fregacmols/RotaryCell/hardware/ag1171-carrier-through-hole/README.md

# AG1171 Carrier Through-Hole — as ordered

Submitted to JLCPCB on August 28, 2026. These files are an immutable record of
the order. Boards from this package have been hand assembled and tested in
multiple working RotaryCell conversions, including calling, ringing, audio and
GPIO21-controlled idle power saving.

| File type | Included |
| --- | --- |
| EasyEDA schematic source | Yes |
| EasyEDA PCB source | Yes |
| Gerber and drill package | Yes |
| Assembly BOM / pick-and-place | No — intended for hand assembly |

Confirm the AG1171 orientation and every connector pin against the schematic before assembly. Do not edit the as-ordered files in place; place subsequent revisions in a new directory.

## Downloads

Filenames were standardized on September 16, 2026. File contents are byte-for-byte identical to the original order exports. Internal EasyEDA project names may retain the historical name.

- Gerbers — upload for PCB fabrication: [ESP-RotaryCell_AG1171-Carrier_Through-Hole_2026-08-28_Gerbers.zip](ESP-RotaryCell_AG1171-Carrier_Through-Hole_2026-08-28_Gerbers.zip)
- PCB source: [ESP-RotaryCell_AG1171-Carrier_Through-Hole_2026-08-28_PCB.json](ESP-RotaryCell_AG1171-Carrier_Through-Hole_2026-08-28_PCB.json)
- Schematic source: [ESP-RotaryCell_AG1171-Carrier_Through-Hole_2026-08-28_Schematic.json](ESP-RotaryCell_AG1171-Carrier_Through-Hole_2026-08-28_Schematic.json)
