fregacmols/RotaryCell/hardware/audio-reset-a4/README.md

# Audio and Reset A4 — as ordered

Submitted to JLCPCB on August 27, 2026. These files are an immutable record of
the order. Boards from this package have been assembled and tested in multiple
working RotaryCell conversions, including bidirectional audio and the GPIO35
hardware power-cycle path.

| File type | Included |
| --- | --- |
| EasyEDA schematic source | Yes |
| EasyEDA PCB source | Yes |
| Gerber and drill package | Yes |
| JLCPCB BOM | Yes |
| JLCPCB pick-and-place | Yes |

The design combines the passive, adjustable audio interface with a hardware
power-cycle circuit that operates the LilyGO physical switch path. The required
guide firmware v0.11.1-dev drives its reset trigger from GPIO35.

Do not edit the as-ordered files in place. Place subsequent revisions in a new directory.

## Downloads

Filenames were standardized on September 16, 2026. File contents are byte-for-byte identical to the original order exports. Internal EasyEDA project names may retain the historical name.

- BOM — upload for assembly: [ESP-RotaryCell_Audio-Reset_RevA4_BOM.csv](ESP-RotaryCell_Audio-Reset_RevA4_BOM.csv)
- Gerbers — upload for PCB fabrication: [ESP-RotaryCell_Audio-Reset_RevA4_Gerbers.zip](ESP-RotaryCell_Audio-Reset_RevA4_Gerbers.zip)
- PCB source: [ESP-RotaryCell_Audio-Reset_RevA4_PCB.json](ESP-RotaryCell_Audio-Reset_RevA4_PCB.json)
- Pick-and-place — upload for assembly: [ESP-RotaryCell_Audio-Reset_RevA4_PickAndPlace.csv](ESP-RotaryCell_Audio-Reset_RevA4_PickAndPlace.csv)
- Schematic source: [ESP-RotaryCell_Audio-Reset_RevA4_Schematic.json](ESP-RotaryCell_Audio-Reset_RevA4_Schematic.json)
