fregacmols/RotaryCell/docs/firmware.md

# Firmware

This section will cover installing and updating RotaryCell firmware as part of a new build.

For the current source and binaries, see the repository's `firmware/current` and `firmware/prebuilt` directories. Detailed build-from-source instructions remain in `FIRMWARE_BUILDING.md` at the repository root.

## Planned documentation

- Selecting the correct firmware release
- Initial USB installation
- Configuration values that must be reviewed for a new build
- SIM and cellular setup
- Maintenance Wi-Fi
- OTA application updates
- Serial diagnostics
- Recovery procedures
