fregacmols/RotaryCell/hardware/legacy/v0.8/Mechanical_README.md

# Mechanical

No release mechanical files exist yet.

Place any validated board-holder or mounting STL used by this release in this folder, along with its editable source file when available. One or two simply named files are sufficient; no additional folder hierarchy is needed unless the project actually grows to require it.
