fregacmols/RotaryCell/hardware/legacy/v0.8/Transformer_Audio_Interface.pdf

## LilyGO SIM7670G - Ag1171 Transformer Audio Interface

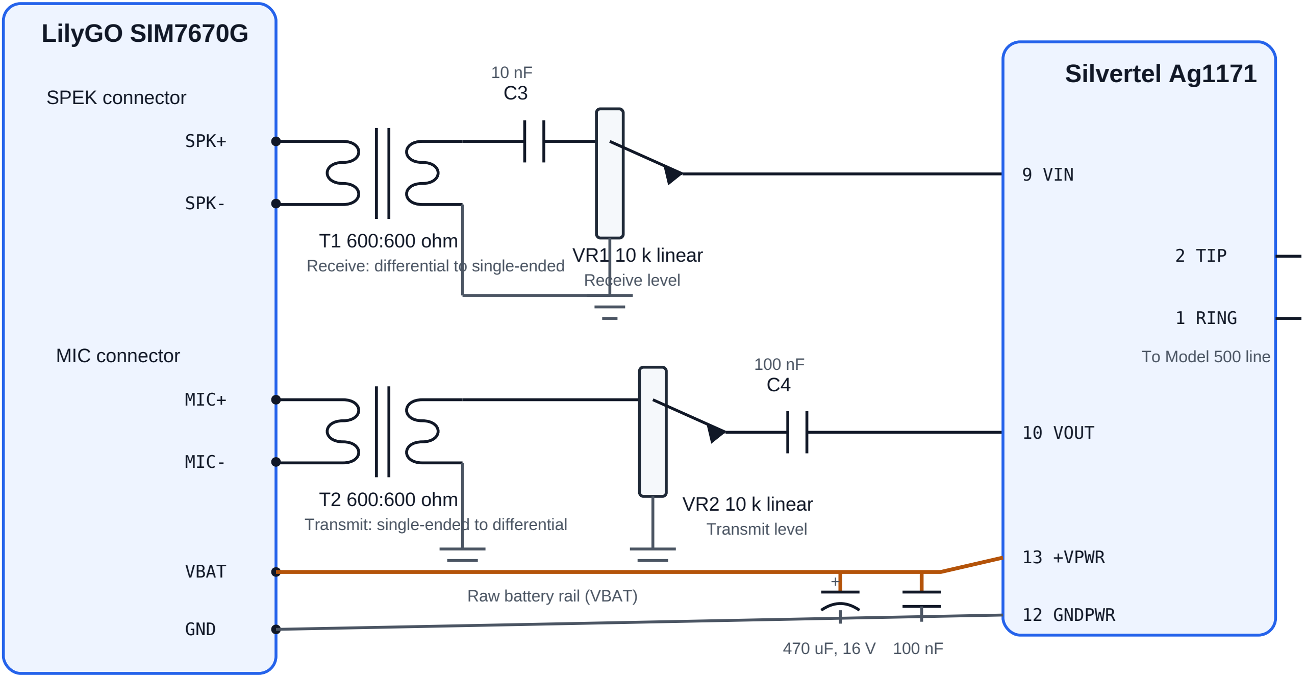
[picture p3: figure]
LilyGO SIM7670G; SPEK connector; SPK+; SPK-; MIC connector; MIC+; MIC-; VBAT; GND; T1 600:600 ohm Receive: differential to single-ended; VR1 10 k linear Receive level; T2 600:600 ohm Transmit: single-ended to differential; VR2 10 k linear Transmit level; Silvertel Ag1171; 9 VIN; 10 VOUT; 13 +VPWR; 12 GNDPWR; 2 TIP; 1 RING; To Model 500 line; Raw battery rail (VBAT)

Initial adjustment: turn both trimmer wipers fully toward ground, then raise levels gradually during a test call.
Do not ground either LilyGO audio conductor; grounding occurs only on the isolated Ag1171 side of each transformer.
