fregacmols/RotaryCell/docs/images/rotarycell-prototype.jpg

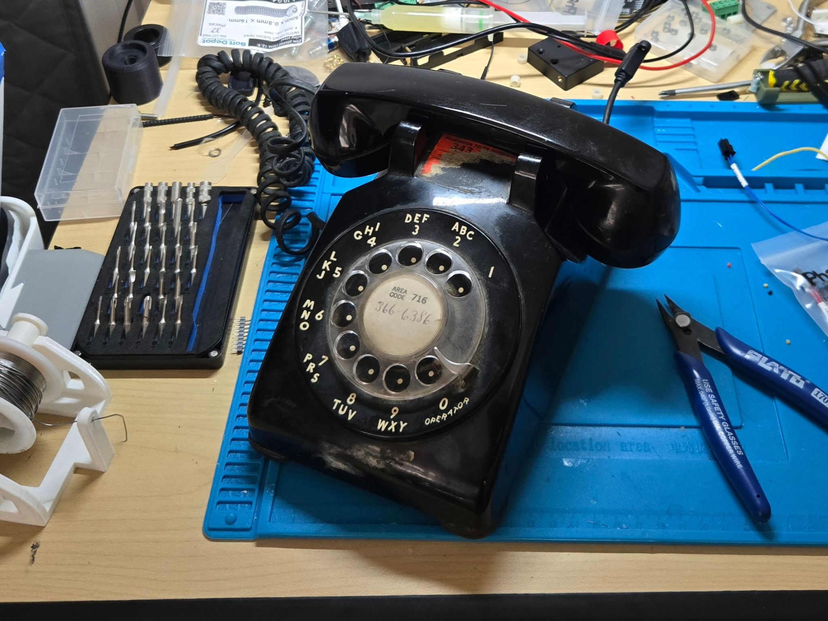
docs/images/rotarycell-prototype.jpg
