fregacmols/RotaryCell/hardware/audio-reset-a4/ESP-RotaryCell_Audio-Reset_RevA4_BOM.csv

ID | Name | Designator | Footprint | Quantity | Manufacturer Part | Manufacturer | Supplier | Supplier Part | Price
1 | 1uF | C1 | C0603 | 1 | CL10A105KB8NNNC | SAMSUNG(三星) | LCSC | C15849 | 0.006
2 | 10nF | C2 | C0603 | 1 | 0603B103K500NT | FH(风华) | LCSC | C57112 | 0.011
3 | 22nF | C3 | C0603 | 1 | CL10B223KB8NNNC | SAMSUNG(三星) | LCSC | C21122 | 0.01
4 | 220nF | C4 | C0603 | 1 | CL10B224KA8NNNC | SAMSUNG(三星) | LCSC | C21120 | 0.017
5 | 100nF | C5,C7 | C0603 | 2 | CC0603KRX7R9BB104 | YAGEO(国巨) | LCSC | C14663 | 0.015
6 | 4.7uF | C6 | C0805 | 1 | CC0805KKX7R6BB475 | YAGEO(国巨) | LCSC | C520074 | 0.083
7 | LILYGO | J1 | CONN-TH_B4B-XH-A-LF-SN | 1 | B4B-XH-A(LF)(SN) | JST | LCSC | C144395 | 0.081
8 | AG1171_AUDIO | J2 | CONN-TH_3P-P2.50_B3B-XH-A-LF-SN | 1 | B3B-XH-A(LF)(SN) | JST | LCSC | C144394 | 0.055
9 | DMP1012USS-13 | Q1 | SOIC-8_L4.9-W3.9-P1.27-LS6.0-BL | 1 | DMP1012USS-13 | DIODES(美台) | LCSC | C3001678 | 0.454
10 | 10K | R1,R4 | R0603 | 2 | 0603WAF1002T5E | UNI-ROYAL(厚声) | LCSC | C25804 | 0.005
11 | 3.3K | R2 | R0603 | 1 | 0603WAF3301T5E | UNI-ROYAL(厚声) | LCSC | C22978 | 0.003
12 | 1K | R3 | R0603 | 1 | 0603WAF1001T5E | UNI-ROYAL(厚声) | LCSC | C21190 | 0.003
13 | 820kΩ | R5 | R0603 | 1 | FRC0603F8203TS | FOJAN(富捷) | LCSC | C2907070 | 0.003
14 | 10kΩ | R6 | R0603 | 1 | 0603WAF1002T5E | UNI-ROYAL(厚声) | LCSC | C25804 | 0.005
15 | 100kΩ | R7,R9 | R0603 | 2 | 0603WAF1003T5E | UNI-ROYAL(厚声) | LCSC | C25803 | 0.004
16 | 1kΩ | R8 | R0603 | 1 | 0603WAF1001T5E | UNI-ROYAL(厚声) | LCSC | C21190 | 0.003
17 | SN74LVC1G123DCTT | U1 | SM8_L3.0-W2.8-P0.65-LS4.0-BL | 1 | SN74LVC1G123DCTT | TI(德州仪器) | LCSC | C354447 | 0.826
18 | B3B-XH-A(LF)(SN) | U2 | CONN-TH_3P-P2.50_A2501WV2-3P | 1 | B3B-XH-A(LF)(SN) | JST | LCSC | C144394 | 0.055
19 | 10K | SPK_LVL,MIC_LVL | RES-ADJ-TH_3362P | 2 | 3362P-1-103LF | BOURNS | LCSC | C58159 | 0.397
