fregacmols/RotaryCell/docs/legacy/v0.8/BOM.md

# Bill of Materials — v0.8 Prototype

Quantities and mounting hardware may vary with the physical build.

| Qty | Item | Notes |
|---:|---|---|
| 1 | Western Electric/AT&T Model 500 telephone | Original handset, dial, hookswitch, network, and bells retained |
| 1 | LilyGO T-A7670G-S3 Standard | A7670G-LLSE cellular modem board |
| 1 | Silvertel AG1171 | Ringing SLIC / telephone-line interface |
| 2 | 600:600-ohm audio transformer | EI-14-style telephone/audio transformer used in prototype |
| 2 | 10-kohm linear trimmer/potentiometer | VR1 receive, VR2 transmit |
| 1 | 10 nF capacitor | Receive coupling into AG1171 VIN |
| 1 | 100 nF capacitor | Transmit coupling from AG1171 VOUT |
| 1 | 100 nF capacitor | AG1171 supply bypass |
| 1 | 470 uF, 16 V capacitor | AG1171 supply bulk capacitor |
| 3 | 1-kohm resistor | Protective series resistors for control lines per Rev B schematic |
| 1 | Protected single-cell Li-ion battery | Appropriate size/capacity for installation |
| 1 | SpeedTalk or compatible SIM | Voice service compatible with A7670G and local network |
| as needed | Perfboard, wire, headers, connectors, heat-shrink, mounting hardware | Prototype construction |

Refer to the release schematics before purchasing or wiring components.
