fregacmols/RotaryCell/guide/docs/downloads/printed-parts/ag1171.stl

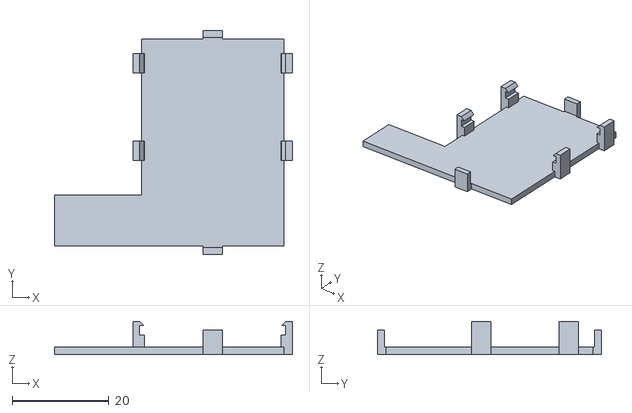
[picture p11: CAD file, 2026-09-25]
guide/docs/downloads/printed-parts/ag1171.stl
49.1 x 46.2 x 6.90
