fregacmols/RotaryCell/guide/docs/downloads/rear-connectors/Rect_USB_TestFit_R3.stl

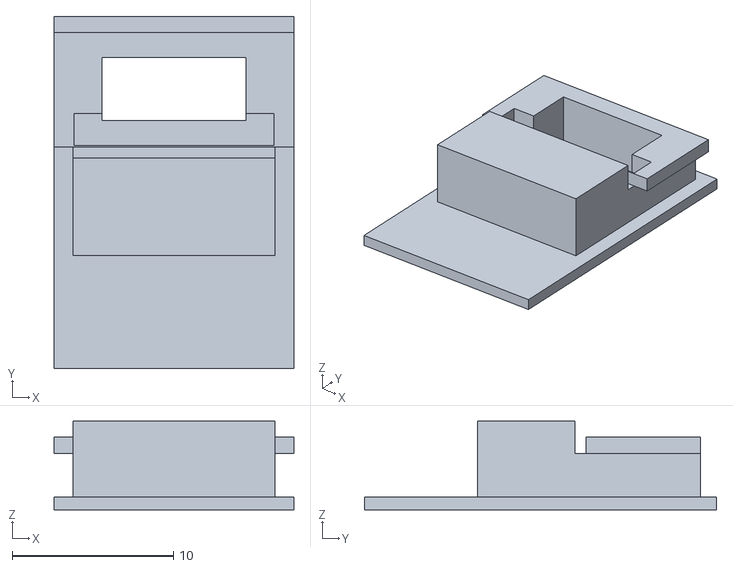
[picture p12: CAD file, 2026-09-25]
guide/docs/downloads/rear-connectors/Rect_USB_TestFit_R3.stl
14.9 x 21.8 x 5.50
