fregacmols/RotaryCell/guide/docs/downloads/printed-parts/audio.stl

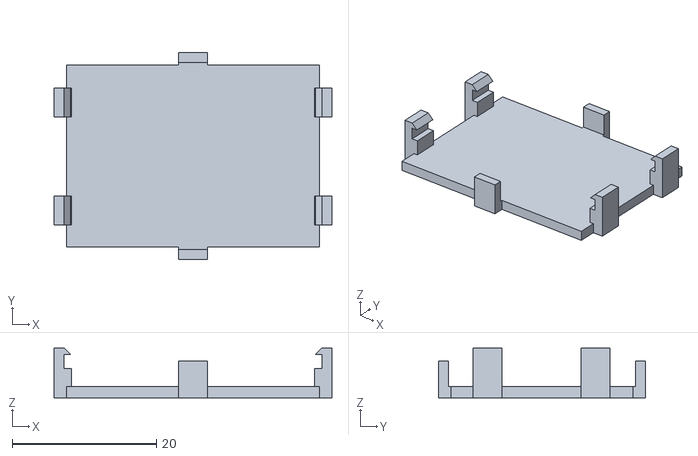
[picture p13: CAD file, 2026-09-25]
guide/docs/downloads/printed-parts/audio.stl
38.5 x 28.6 x 6.90
