fregacmols/RotaryCell/guide/docs/downloads/rear-connectors/Arch_USB_TestFit_R1.stl

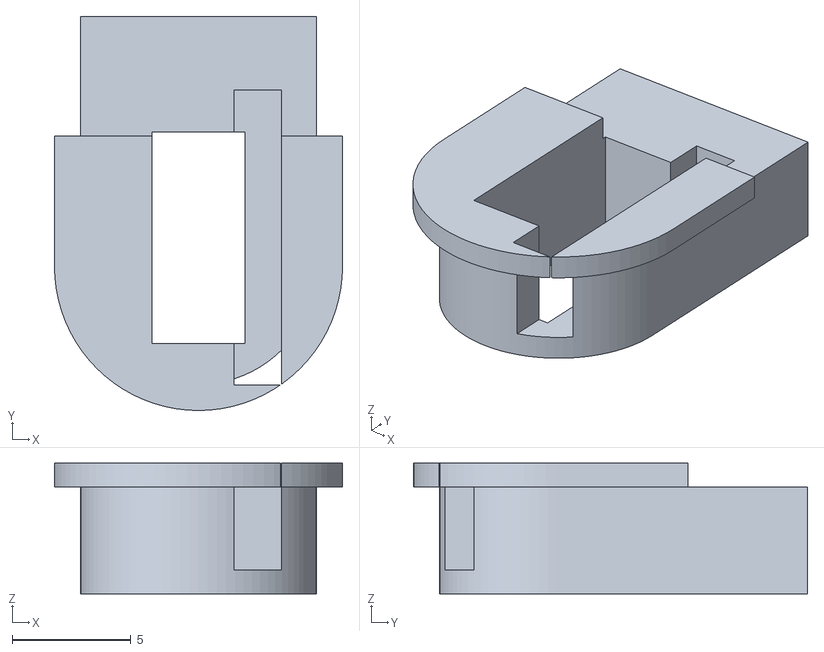
[picture p14: CAD file, 2026-09-25]
guide/docs/downloads/rear-connectors/Arch_USB_TestFit_R1.stl
12.1 x 16.6 x 5.50
