fregacmols/RotaryCell/guide/docs/downloads/printed-parts/LilyGO_Dial_Support_Carrier.stl

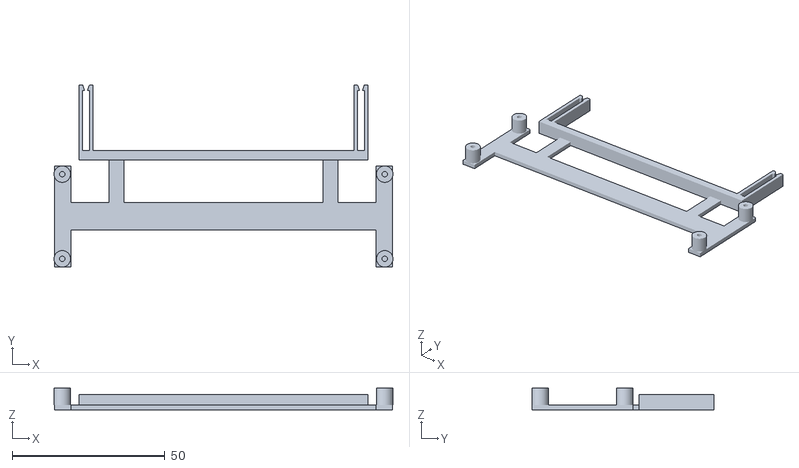
[picture p15: CAD file, 2026-09-25]
guide/docs/downloads/printed-parts/LilyGO_Dial_Support_Carrier.stl
111.0 x 59.6 x 7.10
