fregacmols/RotaryCell/guide/docs/mounting.md

<span class="kicker">RotaryCell / build guide</span>

# Install the assemblies

The telephone shown here is a Western Electric Model 500. Take a clear photograph of its original wiring before moving anything; wire colors and earlier repairs vary from phone to phone.

## 1. Open the telephone

Turn the phone over and loosen the two housing screws shown below. Lift off the shell without pulling on the wiring.

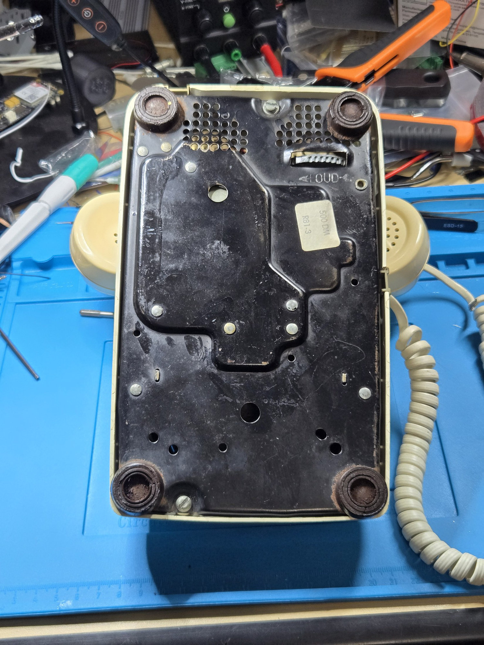
[picture p36: guide/docs/images/phone-housing-screws.jpg]
The two housing screws on the underside of the telephone


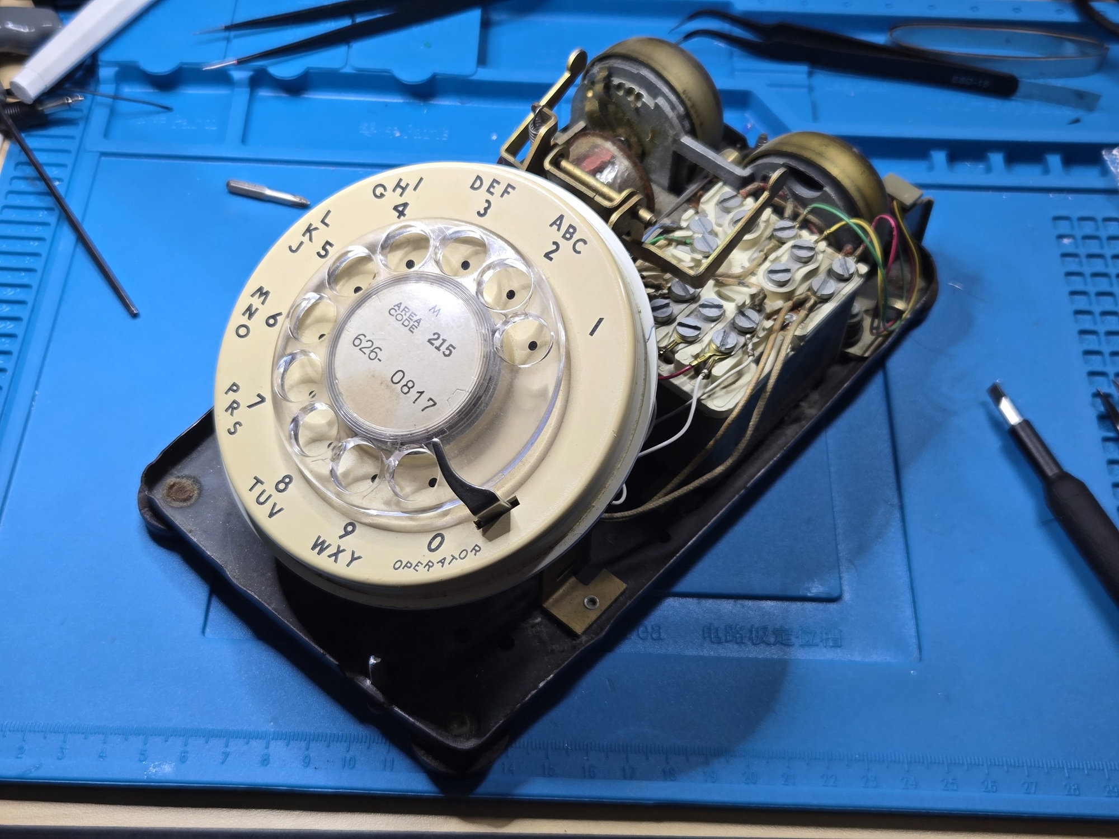
[picture p37: guide/docs/images/phone-housing-removed.jpg]
Telephone with the outer housing removed


Loosen the two flathead screws that retain the dial assembly, one on each mounting post. Back both screws out a good distance, but do not remove them completely. Lift the dial assembly free of the posts and move it aside far enough to expose the base. Leave its original wiring attached and avoid hanging its weight from the wires. Close-up photographs of these screws appear later when the dial is reinstalled.

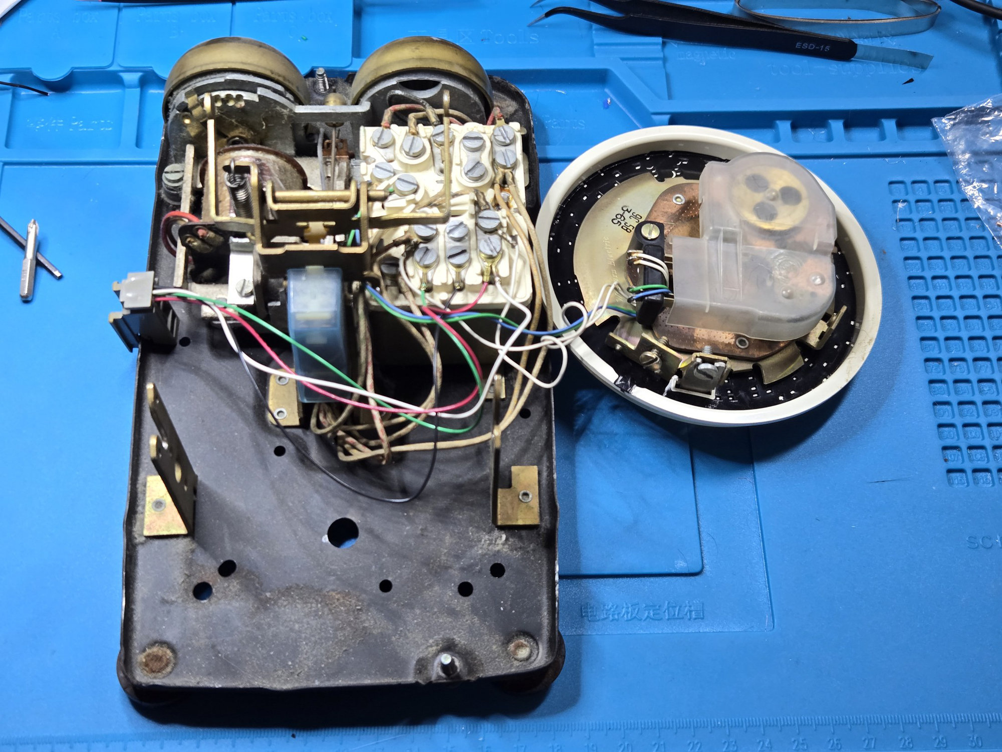
[picture p38: guide/docs/images/phone-dial-moved-aside.jpg]
Dial assembly moved aside while its wiring remains connected


## 2. Free the rear-connector wiring

The original modular jack in this phone used four spade lugs on the network block. Photograph their locations, then disconnect them so the network terminals and rear opening are available for the RotaryCell installation. The next page covers the available rear-connector options.

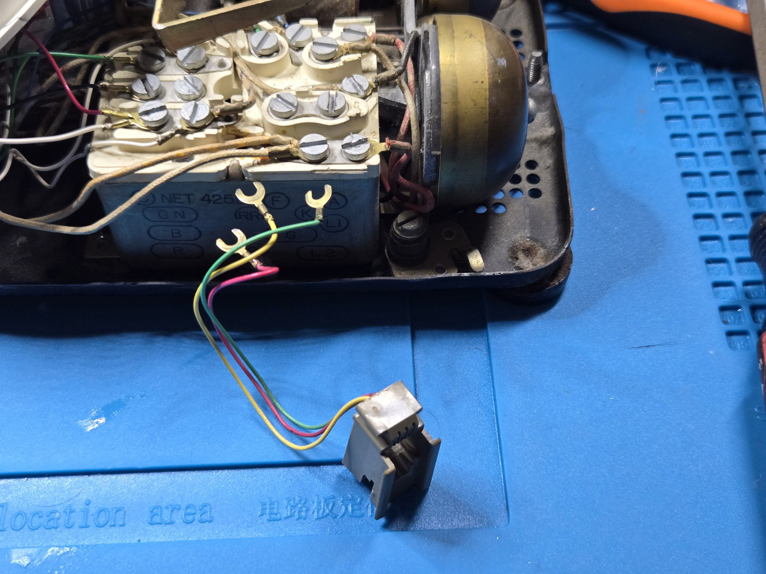
[picture p39: guide/docs/images/phone-original-jack-wiring.jpg]
Original modular jack wiring disconnected from the network block


## 3. Fit the board carriers

Apply 3M VHB tape to the underside of the two small printed carriers as shown. Press them onto the metal base in the positions shown in the following photograph.

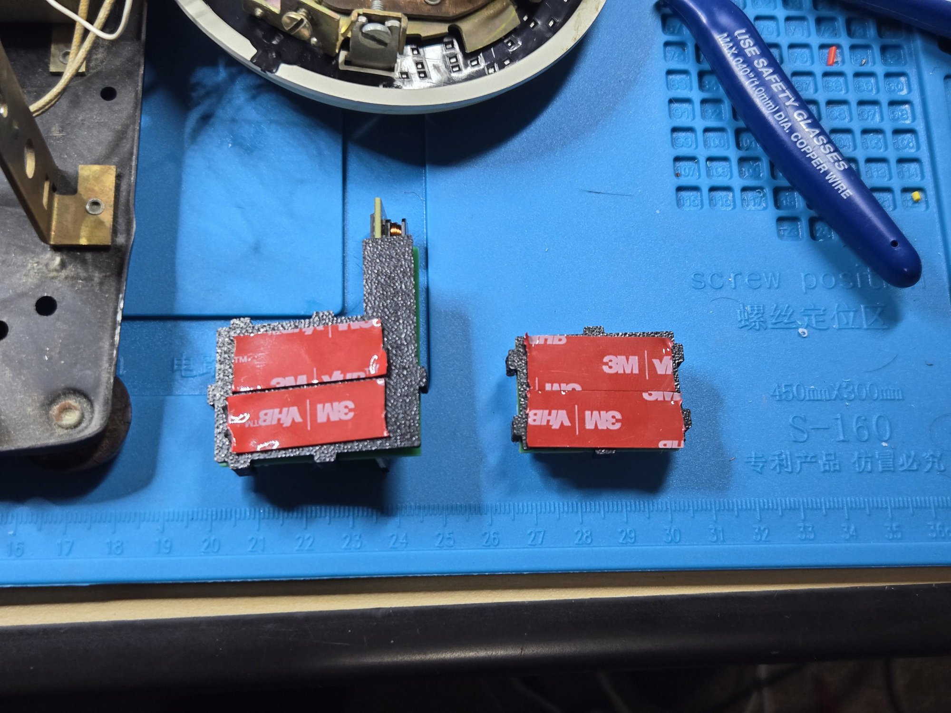
[picture p40: guide/docs/images/phone-carriers-adhesive.jpg]
VHB tape fitted to the underside of the two small board carriers


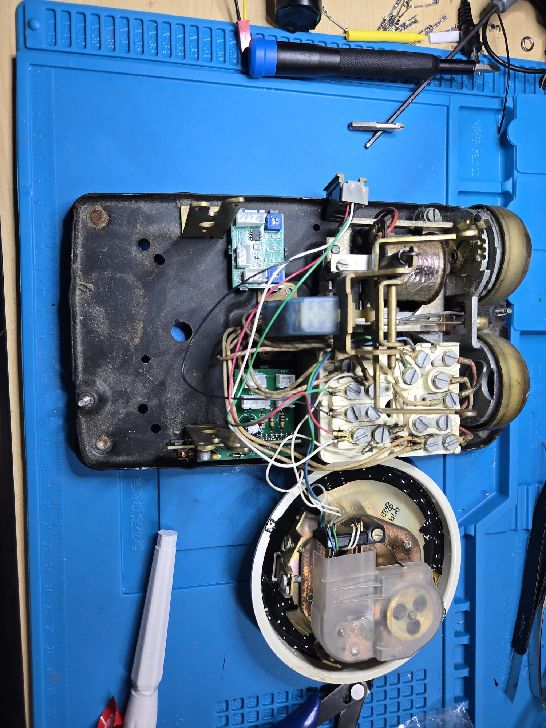
[picture p41: guide/docs/images/phone-carriers-installed.jpg]
Audio and AG1171 carrier assemblies installed on the telephone base


Fit the LilyGO and its printed carrier along the open left side of the base. Plug in the prepared harnesses while the connectors are still easy to reach.

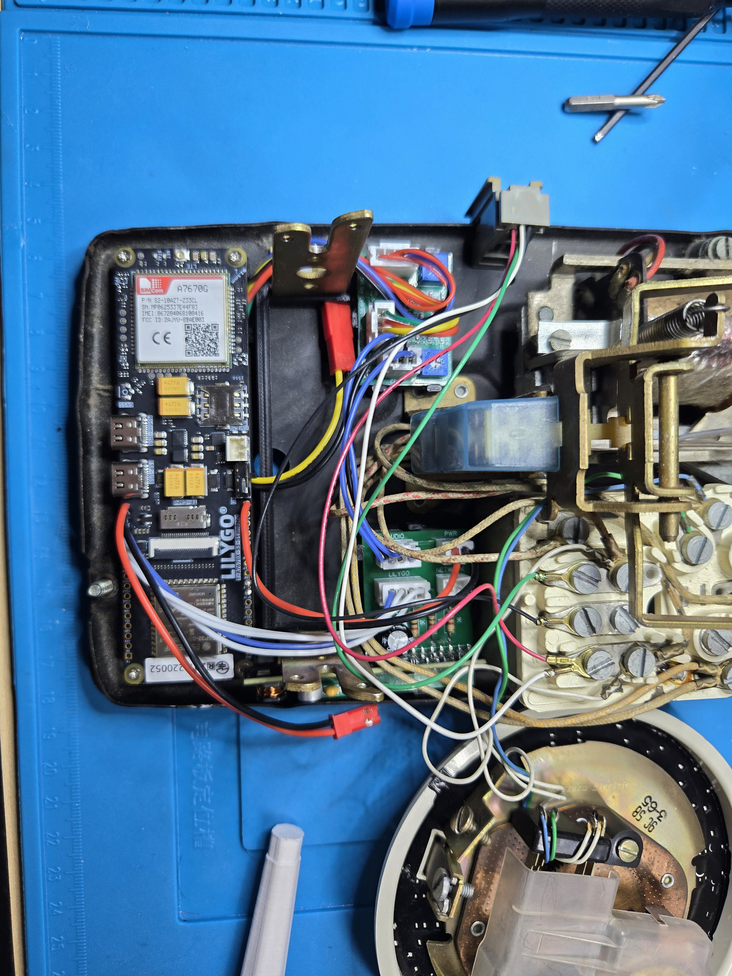
[picture p42: guide/docs/images/phone-boards-installed.jpg]
LilyGO and the two smaller boards installed and connected


## 4. Add the battery and telephone connection

Place the insulated 21700 between the LilyGO and the upper board. The lead lengths are intentionally different so the connectors reach their boards without leaving large coils of wire in the phone.

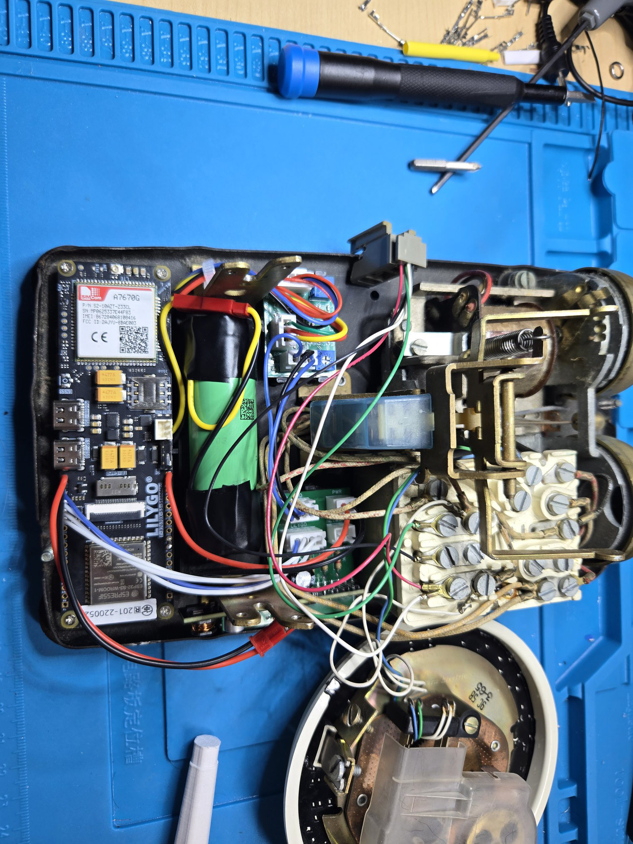
[picture p43: guide/docs/images/phone-battery-installed.jpg]
Battery installed between the LilyGO and the other assemblies


Connect the carrier's two-wire `NETWORK` harness to the telephone's original
incoming-line points on the network block. Green is tip and red is ring in this
build.

!!! warning "Network blocks vary"
    The photograph shows one particular telephone. Trace the original incoming
    line connection or consult the schematic for your telephone; do not copy
    these terminal positions or rely on its wire colors for a different model
    or revision. This internal pair must never be connected to the public
    telephone network or energized premises wiring.

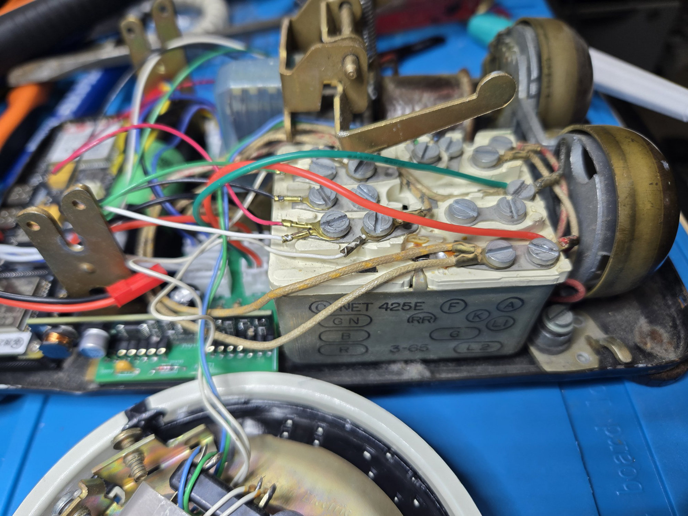
[picture p44: guide/docs/images/phone-network-tip-ring.jpg]
Green tip and red ring leads connected to the telephone network block


At this stage all three boards and the battery should sit below the dial mechanism, with the wiring lying inside the perimeter of the base. Leave the dial loose until firmware, calling and audio tests are complete.
