fregacmols/RotaryCell/guide/docs/index.md

<div class="hero">
  <div class="hero-copy">
    <span class="kicker">The RotaryCell build guide</span>
    <h1>Convert a rotary phone for cellular service.</h1>
    <p class="lead">Build the electronics, prepare the wiring, load the firmware and install RotaryCell in a Western Electric 500-series telephone.</p>
    <a href="materials.html" class="md-button md-button--primary">Start with materials →</a>
  </div>
  <div class="hero-visual">
    Completed red RotaryCell telephone centered on an electronics workbench
    <span>A completed RotaryCell conversion</span>
  </div>
</div>

<div class="intro-notes">
  <section>
    <span class="note-label">Before you begin</span>
    <h2>Experience expected</h2>
    <p>This is not an introductory electronics project. You should be comfortable soldering and desoldering, crimping small contacts, following pinouts and checking your work with a multimeter.</p>
  </section>
  <section>
    <span class="note-label">A note on the photos</span>
    <h2>Several phones, one guide</h2>
    <p>The photographs were taken across several builds. Shell colors, network blocks, original wiring and routing vary. Follow labels and written connections; use the photos for orientation and clearance. Wire colors only matter where the text assigns them a function.</p>
  </section>
</div>

## Build sequence

Follow the project in order from sourcing through the first call. Preparing the
LilyGO contains nearly all of the fine soldering and accounts for roughly
**80% of the hands-on assembly**. The work becomes much more straightforward
after that stage.

<div class="journey">
  <a class="journey-step" href="materials.html"><span class="step-number">01</span><span class="step-copy"><strong>Materials and sourcing</strong><small>Choose the parts, order the boards and prepare your tools.</small></span><span class="step-arrow">→</span></a>
  <a class="journey-step featured" href="lilygo.html"><span class="step-number">02</span><span class="step-copy"><strong>Prepare the LilyGO <em>Most of the hands-on work</em></strong><small>Remove the original holder and add the battery, audio, power and control connections.</small></span><span class="step-arrow">→</span></a>
  <a class="journey-step" href="assembly.html"><span class="step-number">03</span><span class="step-copy"><strong>Boards and wiring</strong><small>Populate the carrier, prepare the cables and assemble the battery leads.</small></span><span class="step-arrow">→</span></a>
  <a class="journey-step" href="firmware.html"><span class="step-number">04</span><span class="step-copy"><strong>Firmware and SIM</strong><small>Load the software and establish cellular service.</small></span><span class="step-arrow">→</span></a>
  <a class="journey-step" href="mounting.html"><span class="step-number">05</span><span class="step-copy"><strong>Install and adjust</strong><small>Mount everything, connect the phone and set the audio.</small></span><span class="step-arrow">→</span></a>
  <a class="journey-step" href="checks.html"><span class="step-number">06</span><span class="step-copy"><strong>Final checks</strong><small>Check calling, ringing and battery operation.</small></span><span class="step-arrow">→</span></a>
</div>

The guide follows the LilyGO controller, Audio/Reset A4 board and AG1171
carrier installed in a Western Electric Model 500 telephone.
