fregacmols/RotaryCell/docs/RotaryCell_Complete_Prototype_Wiring.pdf

# RotaryCell - Complete Prototype Wiring and Component Schematic

## Point-to-point hand-wiring guide for the working transformerless prototype

## PROTOTYPE HAND-WIRING REFERENCE

### Drawing RC-001 | Rev A | 2026-08-28

LEGEND: | battery power | audio | control | common ground | optional / not fitted | No PCB/connector abstraction: wires terminate at module pins and components

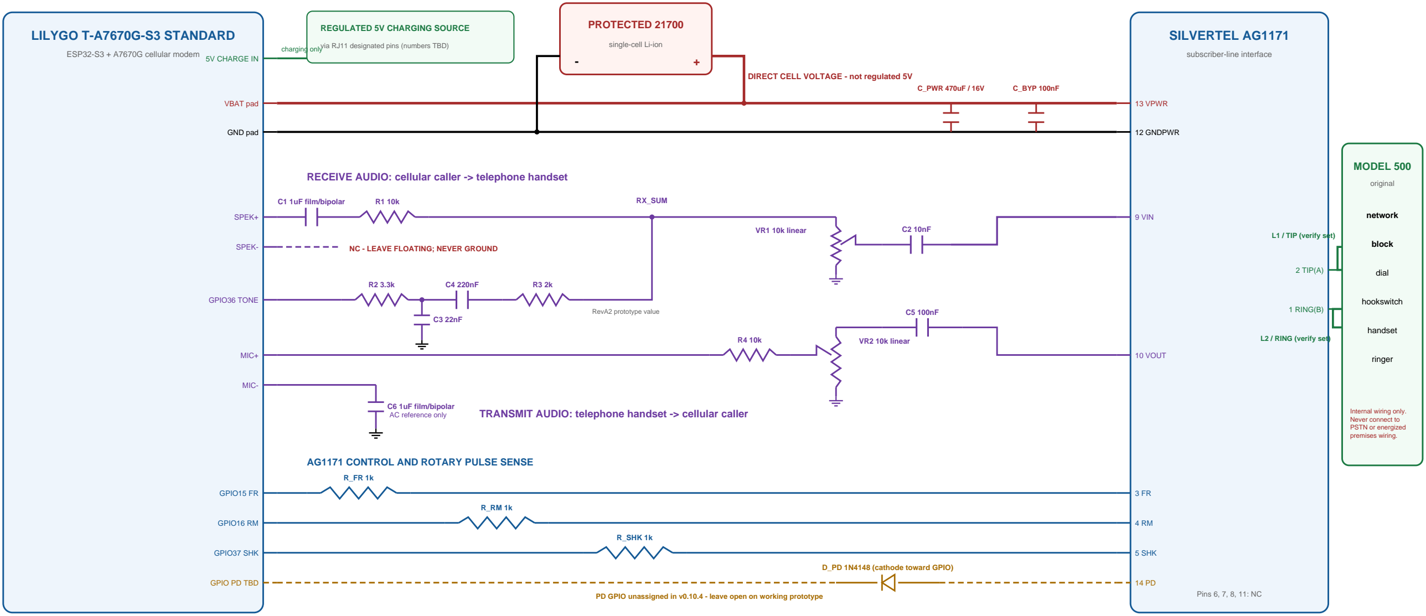
[picture p72: figure]
LILYGO T-A7670G-S3 STANDARD; ESP32-S3 + A7670G cellular modem; SILVERTEL AG1171; subscriber-line interface; MODEL 500; original; network; block; dial; hookswitch; handset; ringer; Internal wiring only. Never connect to PSTN or energized premises wiring.; 5V CHARGE IN; VBAT pad; GND pad; SPEK+; SPEK-; MIC+; MIC-; GPIO36 TONE; GPIO15 FR; GPIO16 RM; GPIO37 SHK; GPIO PD TBD; 13 VPWR; 12 GNDPWR; 9 VIN; 10 VOUT; 5 SHK; 2 TIP(A); 1 RING(B); Pins 6, 7, 8, 11: NC; REGULATED 5V CHARGING SOURCE; PROTECTED 21700; single-cell Li-ion - +; DIRECT CELL VOLTAGE - not regulated 5V; C_PWR 470uF / 16V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

via RJ11 designated pins (numbers TBD) charging only

## RECEIVE AUDIO: cellular caller -> telephone handset

## TRANSMIT AUDIO: telephone handset -> cellular caller

PD GPIO unassigned in v0.10.4 - leave open on working prototype

### BUILD / SAFETY NOTES

1. Audio values are the working RevA2 prototype values; R3 is 2k.
2. SPEK- stays floating. MIC- reaches ground only through the 1uF AC-reference capacitor.
3. The protected 21700 directly feeds LilyGO VBAT and AG1171 VPWR. Never put charging 5V on VPWR.
4. Set both 10k level trimmers for minimum signal before the first call, then raise slowly.
5. AG1171 pins 6, 7, 8, 11 are unconnected. Tip/Ring are internal to the telephone only.
6. RJ11 pin numbers and physical switch solder pads still require labeled photos.

## IMPORTANT: HAND-WIRING FITS, BUT PACKAGING IS CHALLENGING

The prototype can be built entirely from the modules and discrete components shown here and installed inside the original telephone without modifying it. Point-to-point parts and wiring occupy substantially more space than the PCB version, so expect repeated dry-fitting and careful routing.

- Lay out the LilyGO, protected 21700, AG1171, trimmers and audio components before cutting final wire lengths.
- Insulate every exposed joint and provide strain relief. Keep wiring clear of the dial, hookswitch and other moving metalwork.
- Check that the base closes without pinching wires or loading terminals. A complete hand-wired installation is absolutely possible, but it requires patience and deliberate placement.

RotaryCell RC-001 - working prototype hand-wiring reference
