fregacmols/RotaryCell/guide/overrides/main.html

{% extends "base.html" %} {% block announce %} RotaryCell build guide Questions and corrections are welcome. View the RotaryCell repository (https://github.com/fregacmols/RotaryCell) {% endblock %}
