fregacmols/RotaryCell/guide/docs/images/phone-final-wiring-before-closing.jpg

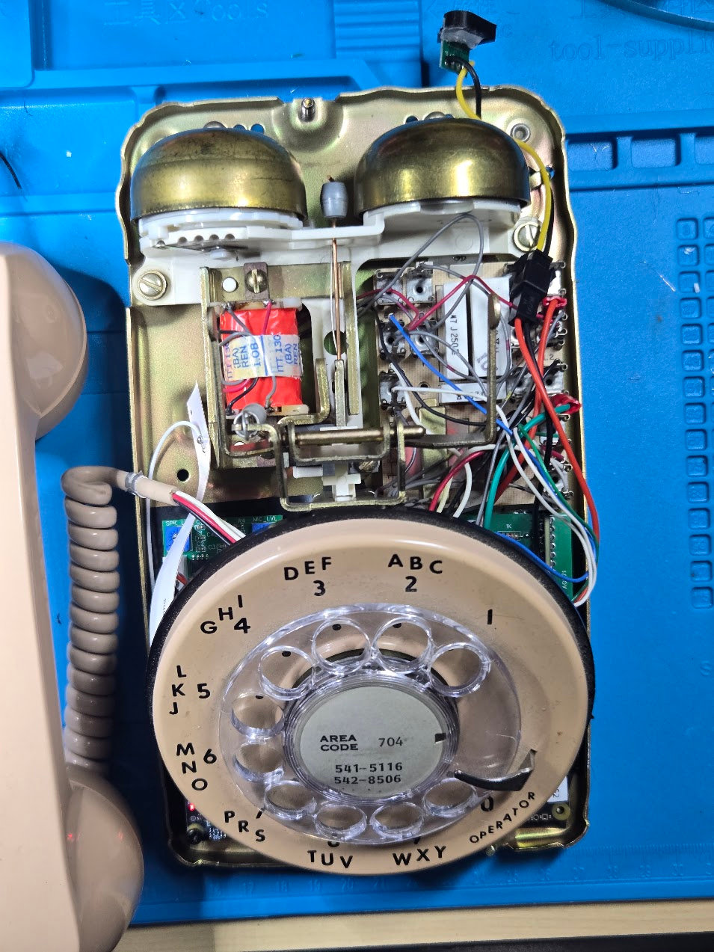
guide/docs/images/phone-final-wiring-before-closing.jpg
