fregacmols/RotaryCell/guide/docs/images/rotarycell-complete-phone.jpg

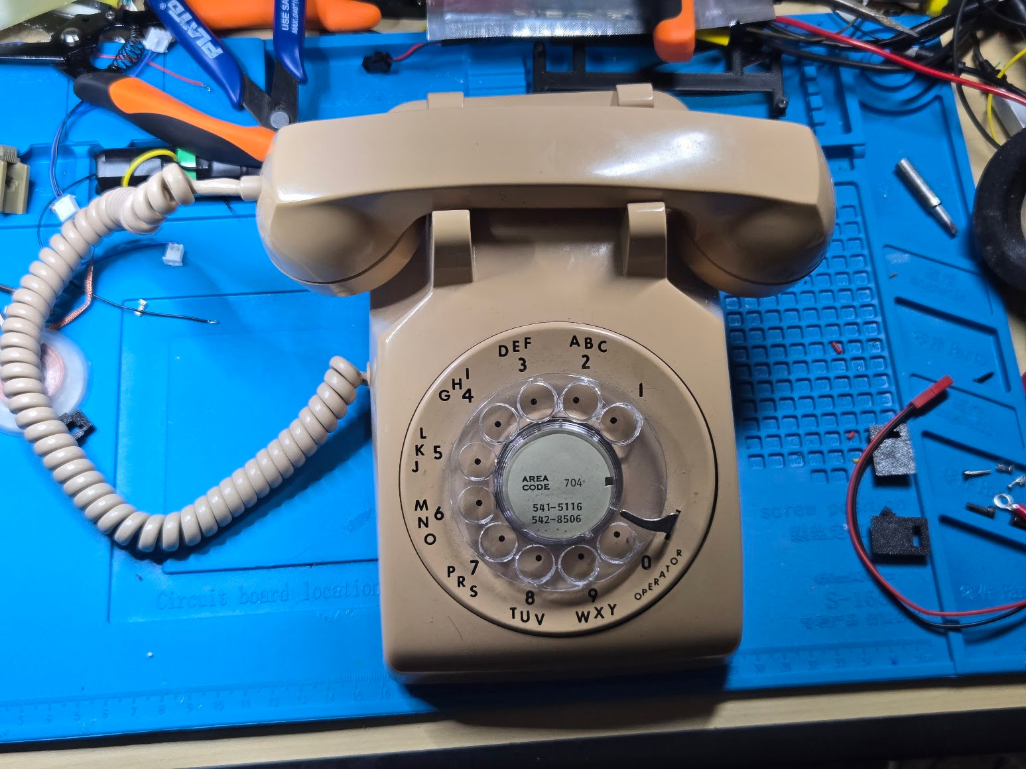
guide/docs/images/rotarycell-complete-phone.jpg
