fregacmols/RotaryCell/hardware/experimental/audio-interface/ESP-CellCore_Active_Audio_Interface_RevE2.pdf

# ESP-CellCore Active Audio Interface - Receive Path

## CELL -> ROTARY: LilyGO SPEK differential output to AG1171 VIN pin 9

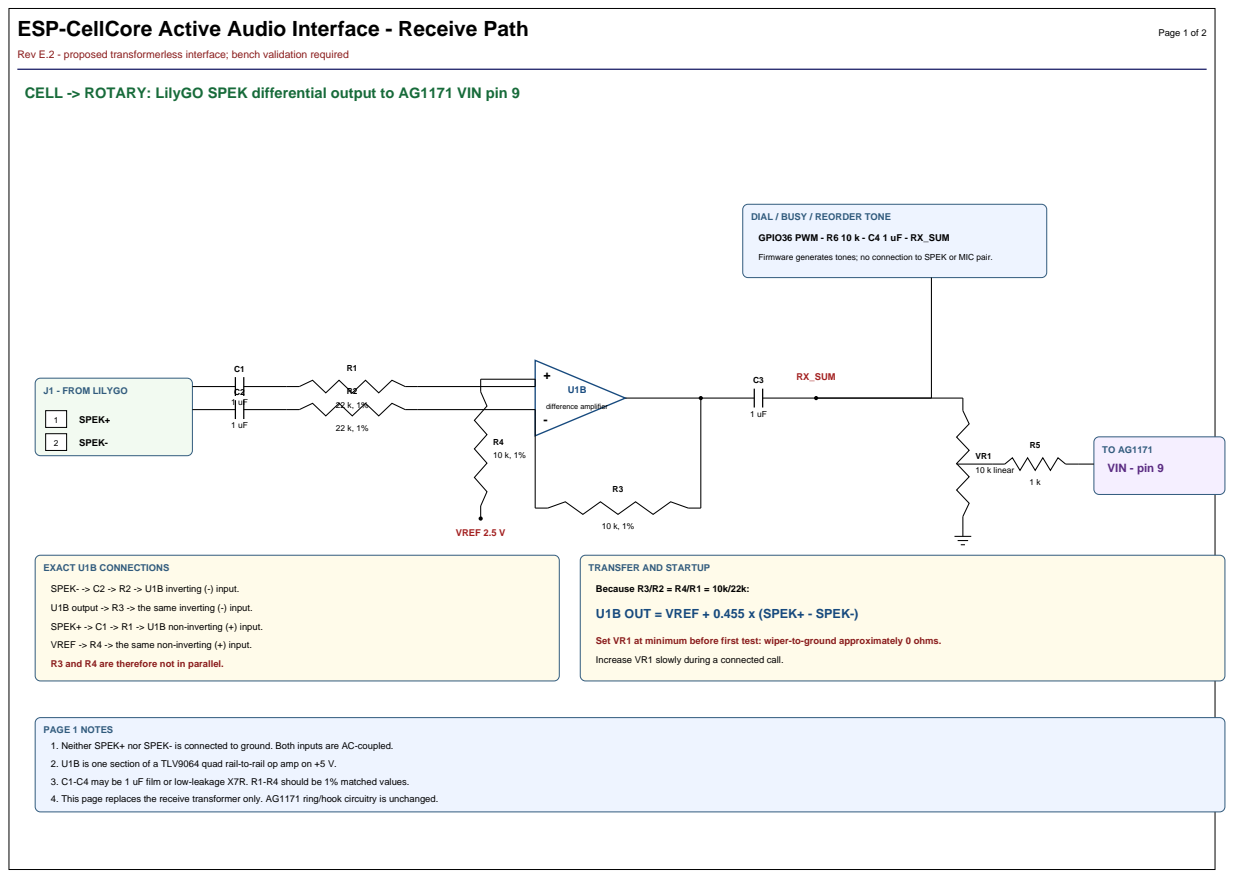
[picture p75: page 1]

Rev E.2 - proposed transformerless interface; bench validation required

DIAL / BUSY / REORDER TONE

Firmware generates tones; no connection to SPEK or MIC pair.

SPEK- -> C2 -> R2 -> U1B inverting (-) input.
U1B output -> R3 -> the same inverting (-) input.
SPEK+ -> C1 -> R1 -> U1B non-inverting (+) input.
VREF -> R4 -> the same non-inverting (+) input.
R3 and R4 are therefore not in parallel.

Because R3/R2 = R4/R1 = 10k/22k:
U1B OUT = VREF + 0.455 x (SPEK+ - SPEK-)

Set VR1 at minimum before first test: wiper-to-ground approximately 0 ohms.
Increase VR1 slowly during a connected call.

PAGE 1 NOTES
1. Neither SPEK+ nor SPEK- is connected to ground. Both inputs are AC-coupled.
2. U1B is one section of a TLV9064 quad rail-to-rail op amp on +5 V.
3. C1-C4 may be 1 uF film or low-leakage X7R. R1-R4 should be 1% matched values.
4. This page replaces the receive transformer only. AG1171 ring/hook circuitry is unchanged.

# ESP-CellCore Active Audio Interface - Transmit + Power

Rev E.2 - proposed transformerless interface; bench validation required

## ROTARY -> CELL: AG1171 VOUT pin 10 to LilyGO MIC differential input

FROM AG1171

### VOUT - pin 10

C5

1 uF

VR2
10 k linear

C6

1 uF

R7
100 k

VREF 2.5 V

+

U1C

unity buffer

+

U1D

inverter about VREF

VREF 2.5 V

R8

10 k, 1%

R9

10 k, 1%

J2 - TO LILYGO

1 | MIC+
2 | MIC-

R10

100 ohm

C7

1 uF

R11

100 ohm

C8

1 uF
TRANSMIT OPERATION

VR2 sets the single-ended audio level from AG1171 VOUT.

U1C outputs VREF + audio.

U1D uses equal R8/R9 and outputs VREF - audio.

C7 and C8 remove the VREF DC bias before MIC+ and MIC-.

Neither MIC+ nor MIC- is grounded.

POWER AND VREF
U1 = TLV9064 quad RRIO op amp, +5 V single supply

U1 supply: pin 4 = +5 V; pin 11 = GND (verify package pinout before build).

Place 100 nF ceramic and 10 uF bulk capacitor directly across U1 supply.

VREF raw: +5 V - 10 k - VREF_RAW - 10 k - GND; 10 uF from VREF_RAW to GND.

Buffer VREF_RAW with U1A as a voltage follower. Buffered output is VREF 2.5 V.

BUILD AND VALIDATION NOTES
1. Start VR2 near minimum and raise it only until the far-end transmit level is adequate.
2. The values shown are a conservative first-pass interface, not yet bench-validated on this exact LilyGO board.
3. Verify LilyGO connector polarity and TLV9064 package pinout before soldering.
4. Keep receive and transmit traces physically separated; use a quiet star ground near AG1171/LilyGO common ground.
