fregacmols/RotaryCell/hardware/experimental/reference/Layoutsketch.jpg

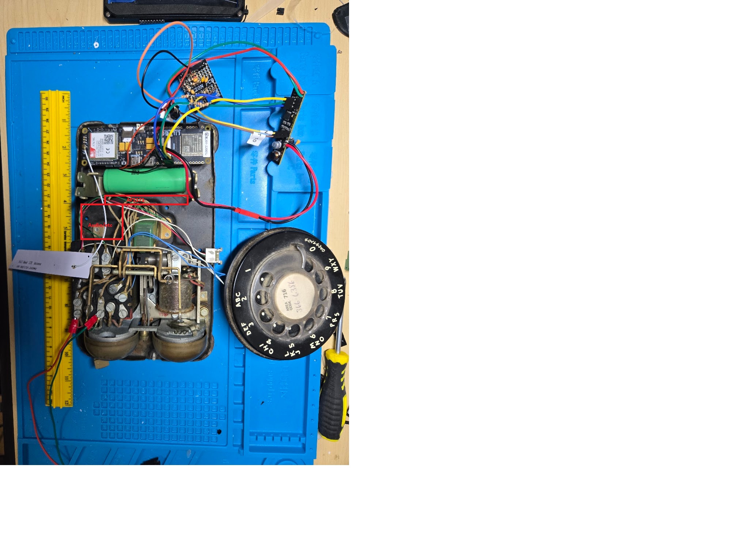
hardware/experimental/reference/Layoutsketch.jpg
