fregacmols/RotaryCell/hardware/experimental/audio-interface/ESP-CellCore_Audio_Board_RevD.pdf

# ESP-CellCore - Complete Audio Interface Board

## Rev D - T1 changed to 8 ohm : 1300 ohm step-up; GPIO36 dial-tone injection added

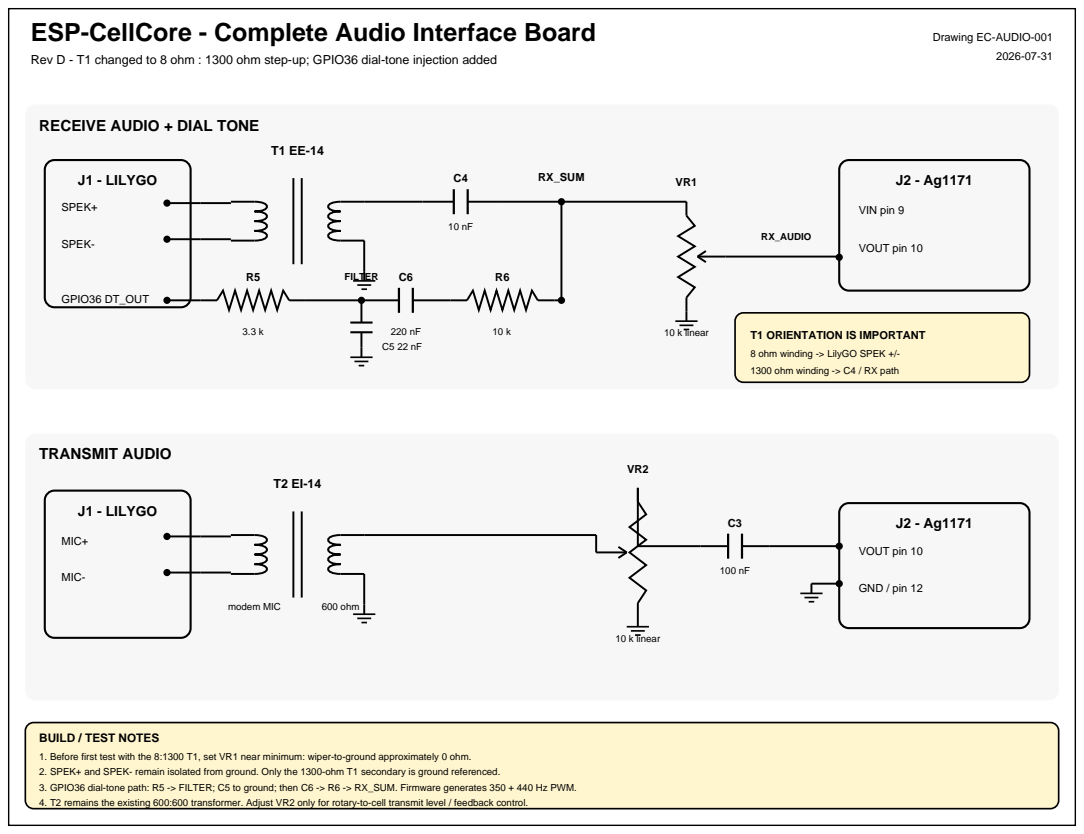
[picture p77: page 1]

RECEIVE AUDIO + DIAL TONE

T1 ORIENTATION IS IMPORTANT
8 ohm winding -> LilyGO SPEK +/-
1300 ohm winding -> C4 / RX path

BUILD / TEST NOTES
1. Before first test with the 8:1300 T1, set VR1 near minimum: wiper-to-ground approximately 0 ohm.
2. SPEK+ and SPEK- remain isolated from ground. Only the 1300-ohm T1 secondary is ground referenced.
3. GPIO36 dial-tone path: R5 -> FILTER; C5 to ground; then C6 -> R6 -> RX_SUM. Firmware generates 350 + 440 Hz PWM.
4. T2 remains the existing 600:600 transformer. Adjust VR2 only for rotary-to-cell transmit level / feedback control.
