fregacmols/RotaryCell/hardware/experimental/audio-interface/ESP-CellCore_Passive_Audio_Board_RevA.pdf

# ESP-CellCore Passive Audio Interface Board - Rev A

## Sheet 1 - Receive audio and GPIO36 tone injection

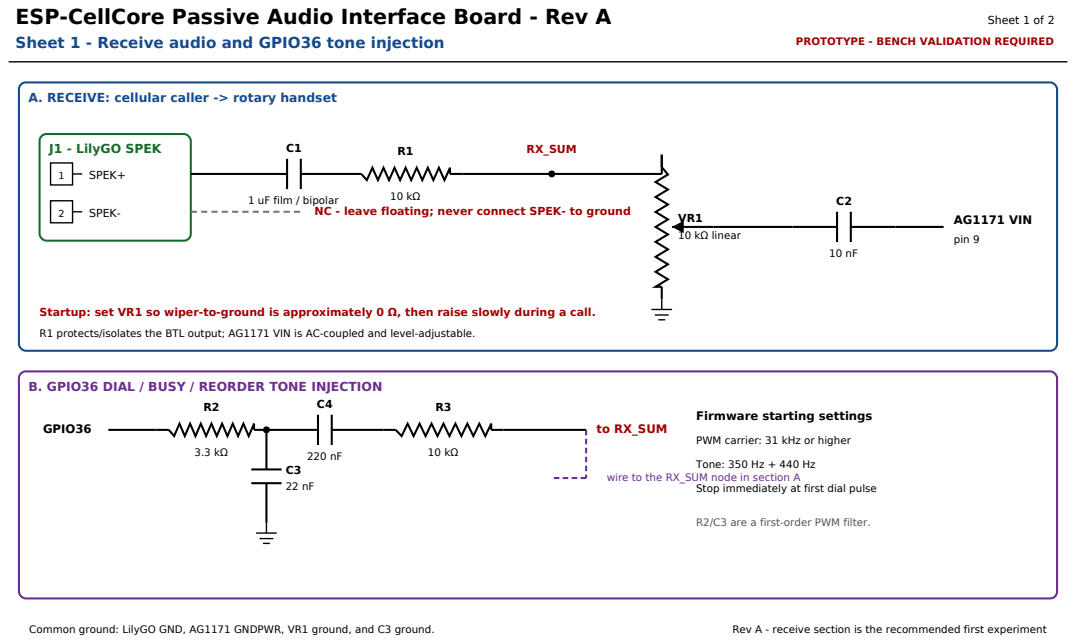
[picture p79: page 1]

PROTOTYPE - BENCH VALIDATION REQUIRED

A. RECEIVE: cellular caller -> rotary handset

NC - leave floating; never connect SPEK- to ground

Startup: set VR1 so wiper-to-ground is approximately 0 Ω, then raise slowly during a call.
R1 protects/isolates the BTL output; AG1171 VIN is AC-coupled and level-adjustable.

B. GPIO36 DIAL / BUSY / REORDER TONE INJECTION

PWM carrier: 31 kHz or higher

wire to the RX_SUM node in section A

Stop immediately at first dial pulse

R2/C3 are a first-order PWM filter.

# ESP-CellCore Passive Audio Interface Board - Rev A

## Sheet 2 - Provisional passive transmit path, measurements, and BOM

Sheet 2 of 2

PROTOTYPE - BENCH VALIDATION REQUIRED

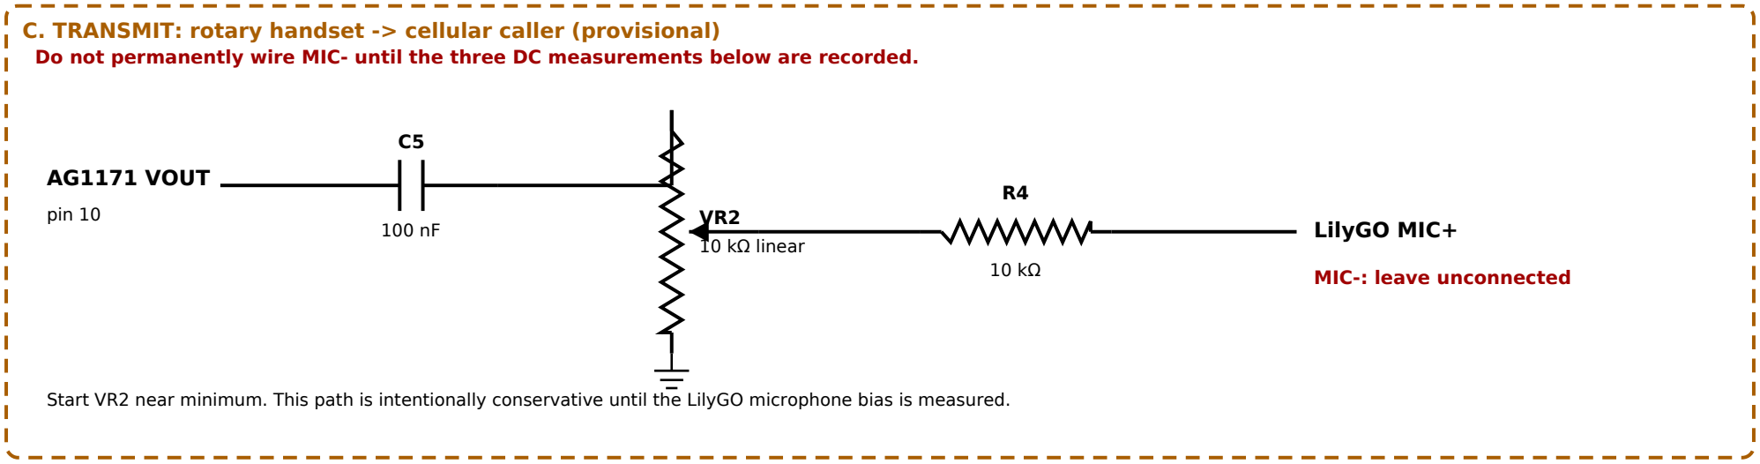
[picture p80: figure]
AG1171 VOUT; pin 10; 10 kΩ linear; LilyGO MIC+; MIC-: leave unconnected

### C. TRANSMIT: rotary handset -> cellular caller (provisional)

Do not permanently wire MIC- until the three DC measurements below are recorded.

Start VR2 near minimum. This path is intentionally conservative until the LilyGO microphone bias is measured.

### D. REQUIRED DC MEASUREMENTS

Power the LilyGO normally, no call active, audio board disconnected:

1. MIC+ to LilyGO GND
2. MIC- to LilyGO GND
3. MIC+ to MIC-

Record polarity and voltage. These readings determine the final transmit topology.

### E. STARTING BOM / BUILD NOTES

VR1, VR2: 10 kΩ linear trimmers

R1, R3, R4: 10 kΩ; R2: 3.3 kΩ

C1: 1 uF film or bipolar

C2: 10 nF; C3: 22 nF; C4: 220 nF

C5: 100 nF

J1: 2-pin SPEK connector; pads for MIC+, GND, GPIO36

Keep the cellular antenna and boost/switching inductors away from audio wiring.

This schematic is intentionally simple and staged: validate receive, then measure MIC bias, then finalize transmit. | No transformers / no op-amps
