fregacmols/RotaryCell/hardware/legacy/v0.8/Complete_Wiring_Diagram.pdf

# ESP-CellCore complete wiring: LilyGO T-A7670G-S3 + Ag1171 + Model 500

Includes audio transformers, level controls, SLIC power, ringing GPIO, pulse-dial sensing, and Silvertel's minimum line protection.

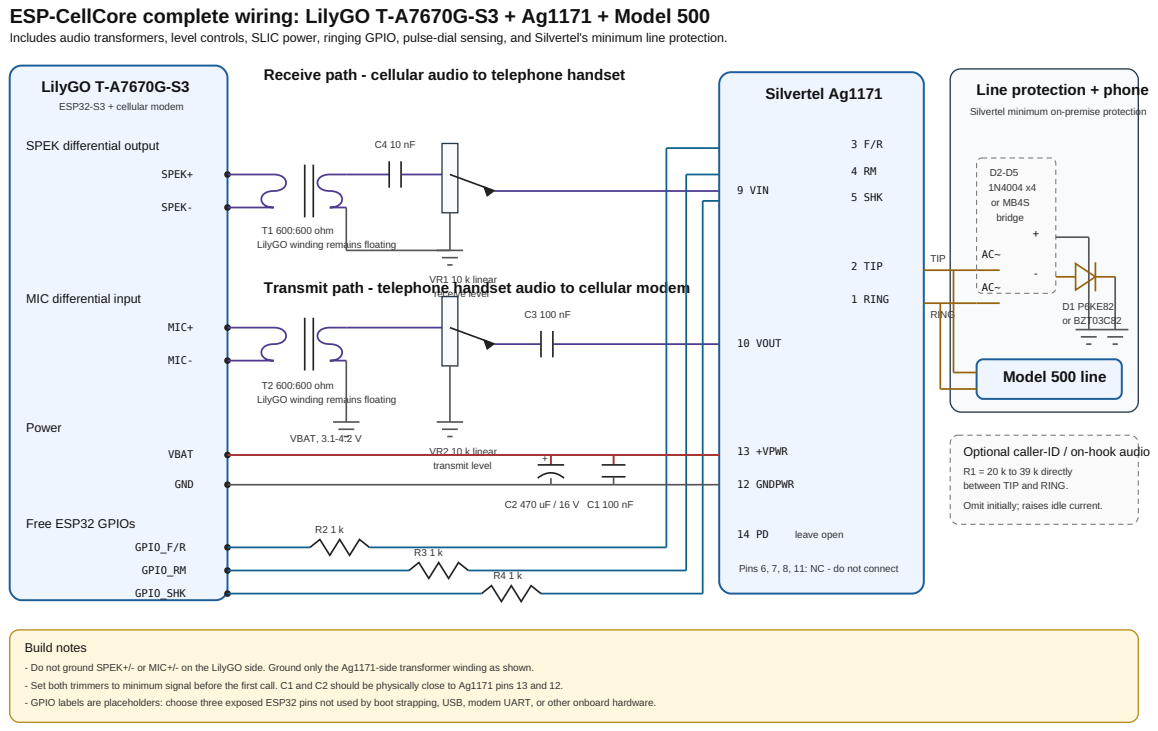
[picture p83: page 1]

Receive path - cellular audio to telephone handset

Silvertel minimum on-premise protection

T1 600:600 ohm
LilyGO winding remains floating

VR1 10 k linear Transmit path - telephone handset audio to cellular modem receive level

T2 600:600 ohm

Optional caller-ID / on-hook audio
R1 = 20 k to 39 k directly
between TIP and RING.
Omit initially; raises idle current.

Pins 6, 7, 8, 11: NC - do not connect

- Do not ground SPEK+/- or MIC+/- on the LilyGO side. Ground only the Ag1171-side transformer winding as shown.
- Set both trimmers to minimum signal before the first call. C1 and C2 should be physically close to Ag1171 pins 13 and 12.
- GPIO labels are placeholders: choose three exposed ESP32 pins not used by boot strapping, USB, modem UART, or other onboard hardware.
