fregacmols/RotaryCell/hardware/legacy/v0.8/ESP-CellCore_Service_Schematic_RevB.pdf

# ESP-CellCore - Model 500 Cellular Conversion

## U1 - LILYGO

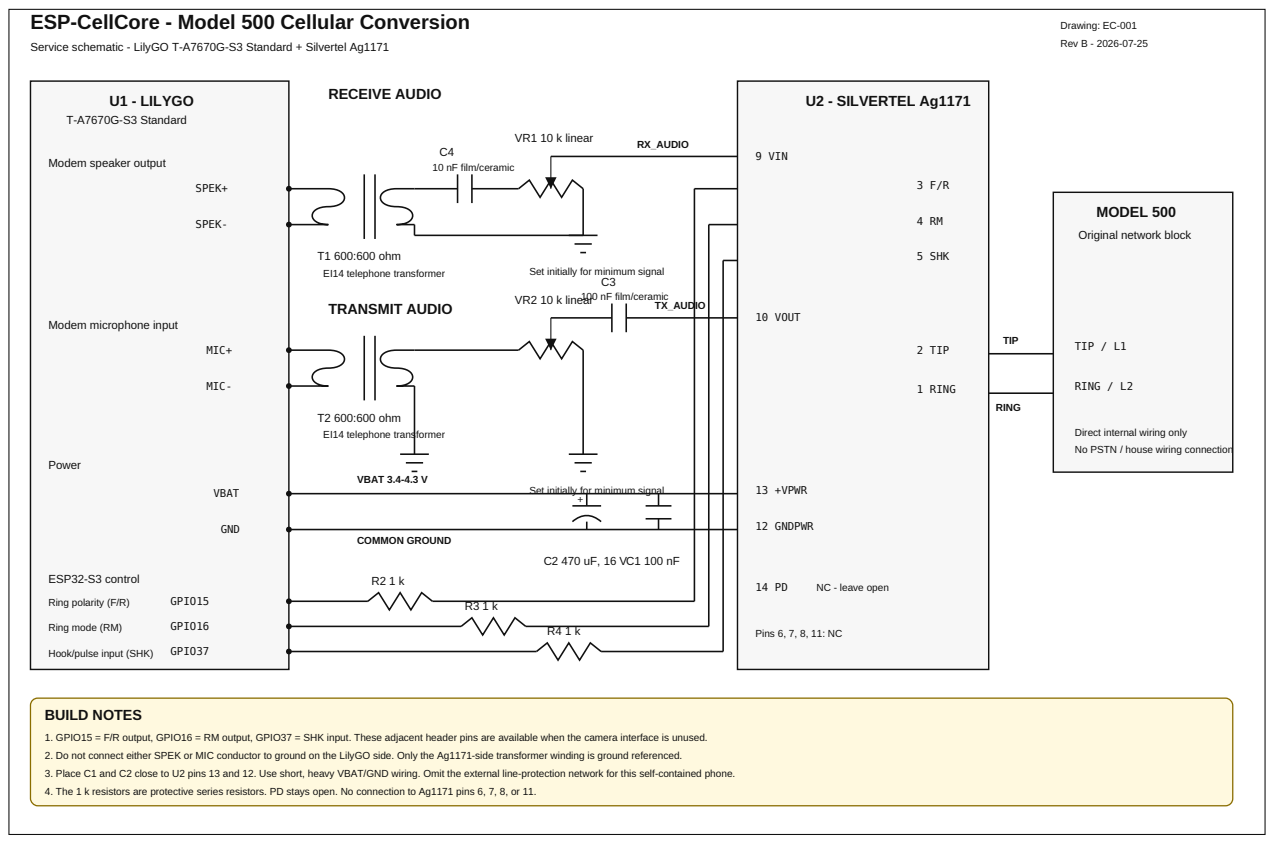
[picture p84: page 1]

Service schematic - LilyGO T-A7670G-S3 Standard + Silvertel Ag1171

Set initially for minimum signal

Direct internal wiring only
No PSTN / house wiring connection

Hook/pulse input (SHK)

1. GPIO15 = F/R output, GPIO16 = RM output, GPIO37 = SHK input. These adjacent header pins are available when the camera interface is unused.
2. Do not connect either SPEK or MIC conductor to ground on the LilyGO side. Only the Ag1171-side transformer winding is ground referenced.
3. Place C1 and C2 close to U2 pins 13 and 12. Use short, heavy VBAT/GND wiring. Omit the external line-protection network for this self-contained phone.
4. The 1 k resistors are protective series resistors. PD stays open. No connection to Ag1171 pins 6, 7, 8, or 11.
