fregacmols/RotaryCell/(list of files, drawings)

Other design files:
hardware/experimental/carrier-board/PCB_ESP-RotaryCell_A1.2e_L-shape_v1.json
hardware/experimental/carrier-board/PCB_ESP-RotaryCell_A1.2e_L-shape_v2_from_sketch.json
hardware/experimental/carrier-board/PCB_PCB_ESP-RotaryCell-Main-Carrier-Rev-A1.2e_2026-08-08.json
hardware/experimental/carrier-board/SCH_ESP-RotaryCell-Main-Carrier-Rev-A0_2026-08-08.json
hardware/experimental/carrier-board/SCH_ESP-RotaryCell-Main-Carrier-Rev-A1.1_CleanLayout_2026-08-08.json
hardware/experimental/carrier-board/SCH_ESP-RotaryCell-Main-Carrier-Rev-A1.2_ElectricalComplete_2026-08-08.json
hardware/experimental/carrier-board/SCH_ESP-RotaryCell-Main-Carrier-Rev-A1.2_SafeCleanup_2026-08-08.json
hardware/experimental/carrier-board/SCH_ESP-RotaryCell-Main-Carrier-Rev-A1.2b_AuditCorrected_2026-08-08.json
hardware/experimental/carrier-board/SCH_ESP-RotaryCell-Main-Carrier-Rev-A1.2b_upload.json
hardware/experimental/carrier-board/SCH_ESP-RotaryCell-Main-Carrier-Rev-A1.2c_parts_harvested.json
hardware/experimental/carrier-board/SCH_ESP-RotaryCell-Main-Carrier-Rev-A1.2d_NativeParts_NetFix.json
hardware/experimental/carrier-board/SCH_ESP-RotaryCell-Main-Carrier-Rev-A1.2e_GND_3V3_Fix.json
hardware/experimental/carrier-board/SCH_ESP-RotaryCell-Main-Carrier-Rev-A1_RealParts.json
hardware/experimental/carrier-board/SCH_ESP-RotaryCell-Main-Carrier-Rev-A1_RealParts_2026-08-08.json
hardware/experimental/carrier-board/SCH_ESP-RotaryCell_Main_Carrier_RevA0.json
hardware/experimental/usb-interlock/SCH_ESP-CellCore-USB-Interlock_2026-08-07.json
hardware/experimental/usb-interlock/SCH_ESP-CellCore_USB_Interlock_RevA2_CLEAN.json
hardware/experimental/usb-interlock/SCH_ESP-CellCore_USB_Interlock_RevA2_IMPORT.json
hardware/experimental/usb-interlock/SCH_ESP-CellCore_USB_Interlock_RevA3.json
hardware/experimental/usb-interlock/SCH_ESP-CellCore_USB_Interlock_RevA3_1.json
hardware/experimental/usb-interlock/SCH_ESP-CellCore_USB_Interlock_RevA3_2.json
hardware/experimental/usb-interlock/SCH_New-Project_2026-08-07.json
hardware/experimental/usb-interlock/SCH_New-Project_2026-08-07_2.json
