fregacmols/RotaryCell/(commit log)

2026-08-15 Organize RotaryCell working repository
    [ESP-RotaryCell_Carrier_RevA0.kicad_pcb, PCB_ESP-RotaryCell_A1.2e_L-shape_v1.json, PCB_ESP-RotaryCell_A1.2e_L-shape_v2_from_sketch.json, PCB_PCB_ESP-RotaryCell-Main-Carrier-Rev-A1.2e_2026-08-08.json, SCH_ESP-CellCore-USB-Interlock_2026-08-07.json, SCH_ESP-CellCore_USB_Interlock_RevA2_CLEAN.json, SCH_ESP-CellCore_USB_Interlock_RevA2_IMPORT.json, SCH_ESP-CellCore_USB_Interlock_RevA3.json]
2026-08-28 Archive August 2026 hardware baseline
    [BOM_ESP-CellCore-Passive-Audio-Board-Rev-A4-Reset-VALIDATED_2026-08-27.csv, PCB_Carrier_PCB_TH_2026-08-28.json, PCB_PCB_ESP-CellCore-Passive-Audio-Board-Rev-A4-Reset-VALIDATED_2026-08-27.json, PickAndPlace_PCB_ESP-CellCore-Passive-Audio-Board-Rev-A4-Reset-VALIDATED_2026-08-27.csv, SCH_Carrier-Board_2026-08-28.json, SCH_ESP-CellCore-Passive-Audio-Board-Rev-A4-Reset-VALIDATED_2026-08-27.json]
2026-08-28 Document current hardware reproduction path
2026-08-28 Clarify LilyGO audio return wiring
2026-08-28 Correct AG1171 direct battery power path
2026-08-28 Add primary hand-wired prototype reference
2026-08-29 Add portable prototype photo to project overview
2026-09-06 Update PCB build status and connector documentation
2026-09-10 Add MkDocs assembly documentation structure
2026-09-10 Add build guide landing page
2026-09-16 Standardize RotaryCell PCB ordering filenames and download links
    [ESP-RotaryCell_Audio-Reset_RevA4_BOM.csv, ESP-RotaryCell_Audio-Reset_RevA4_PickAndPlace.csv]
2026-09-25 Add illustrated RotaryCell build guide
    [Arch_USB_TestFit_R1.stl, LilyGO_Dial_Support_Carrier.stl, Rect_USB_TestFit_R3.stl, ag1171.stl, audio.stl]
2026-09-25 Clarify battery tab attachment options
2026-09-25 Point current firmware to the guide build
2026-10-16 Finalize v0.12.0 naming and disable diagnostic power logging
