fregacmols/RotaryCell/guide/docs/images/phone-corrected-wiring-overview.jpg

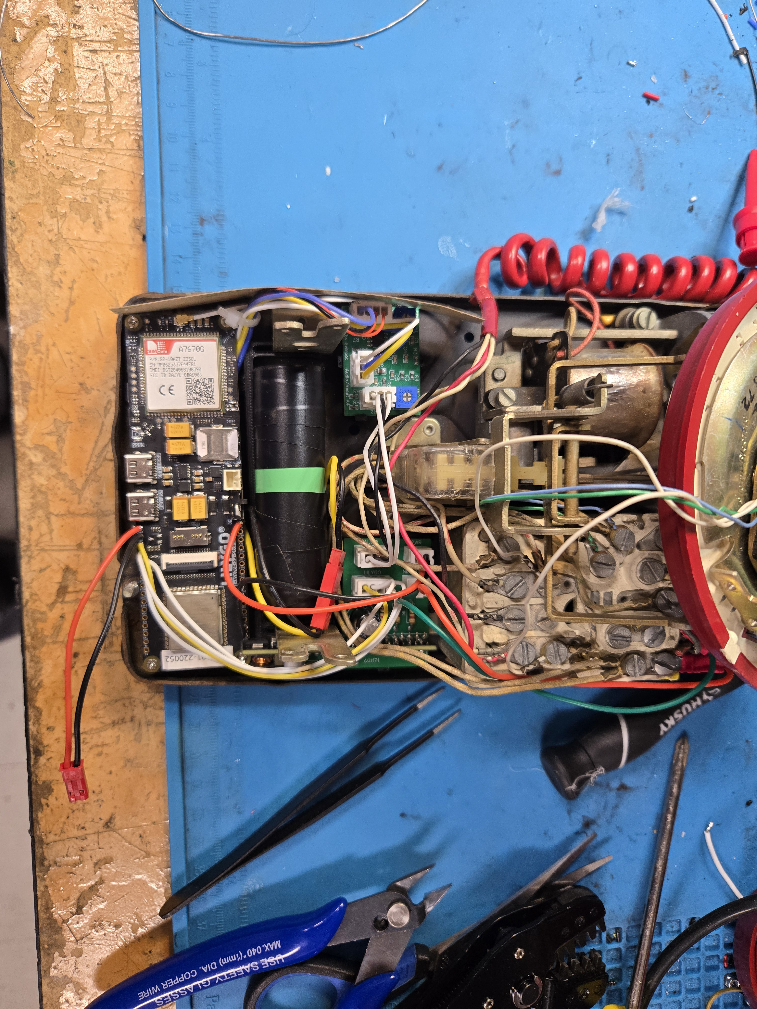
[picture p59: guide/docs/images/phone-corrected-wiring-overview.jpg]
guide/docs/images/phone-corrected-wiring-overview.jpg
